tjaworski997/whisli-bean/docs/screens/pl/button-edit.png

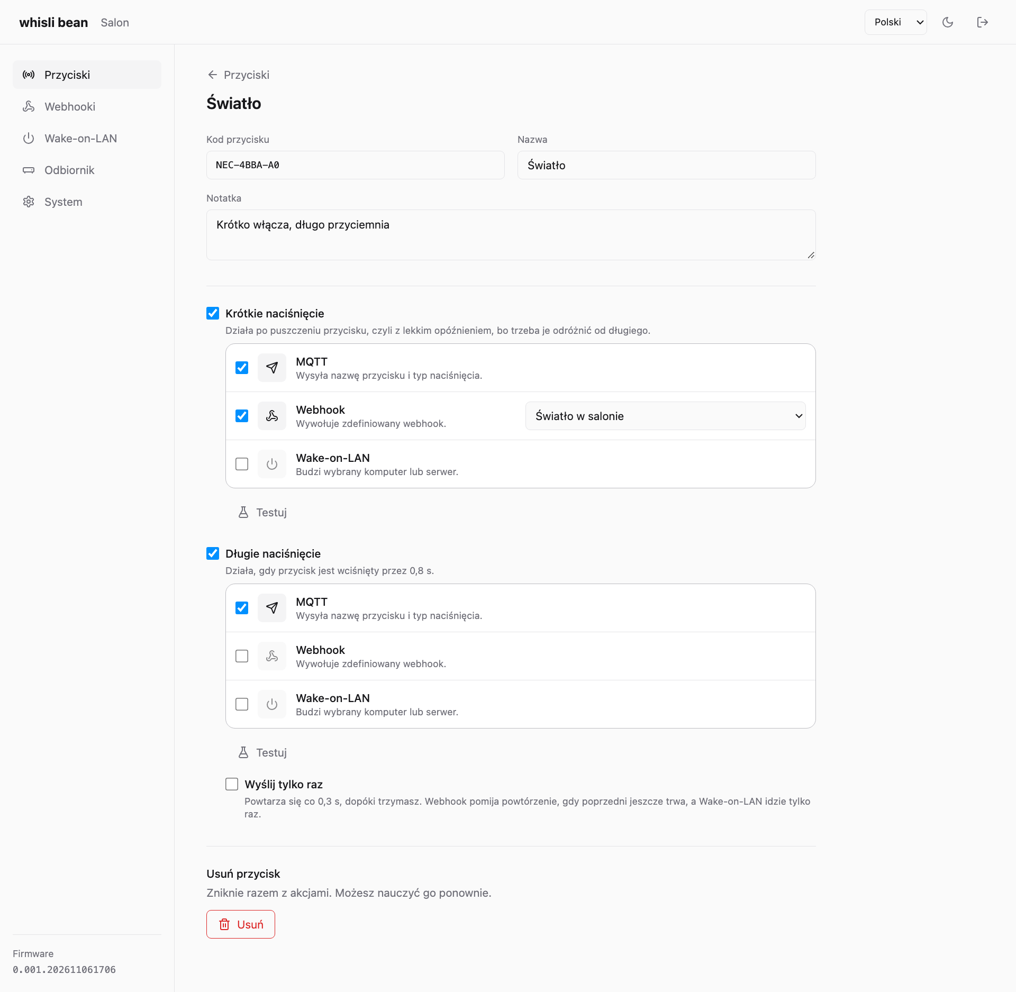
docs/screens/pl/button-edit.png
