tjaworski997/whisli-bean/docs/screens/pl/buttons.png

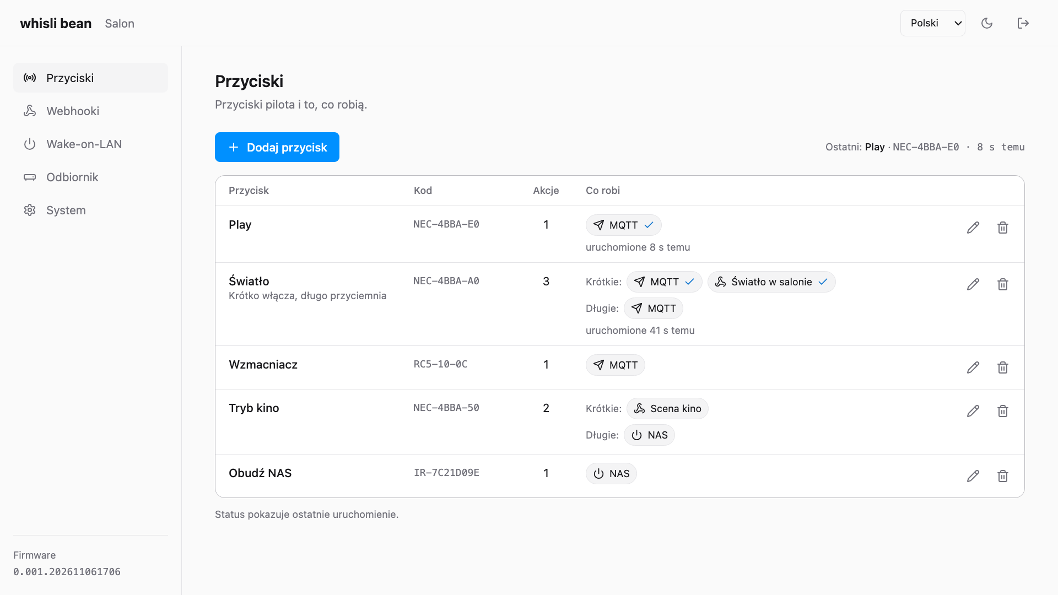
docs/screens/pl/buttons.png
