tjaworski997/whisli-bean/docs/screens/pl/logs.png

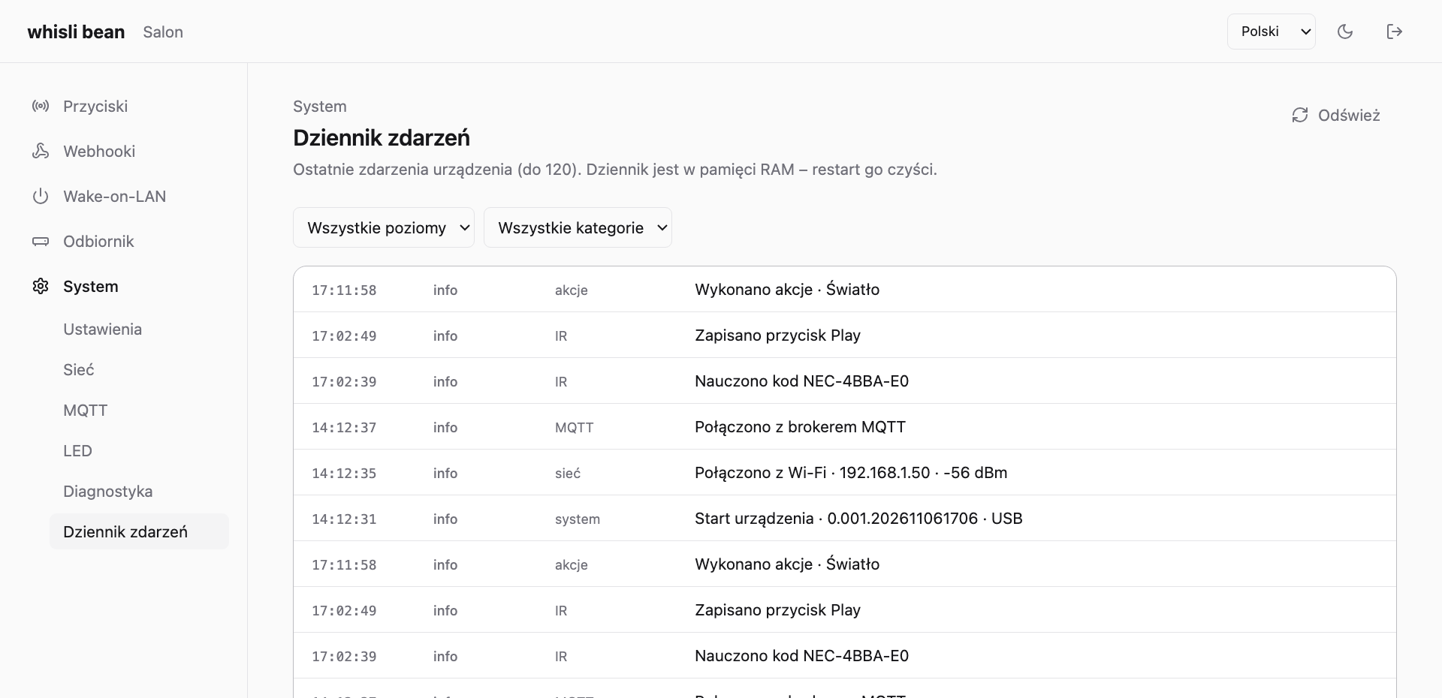
docs/screens/pl/logs.png
