tjaworski997/whisli-bean/docs/screens/pl/mqtt.png

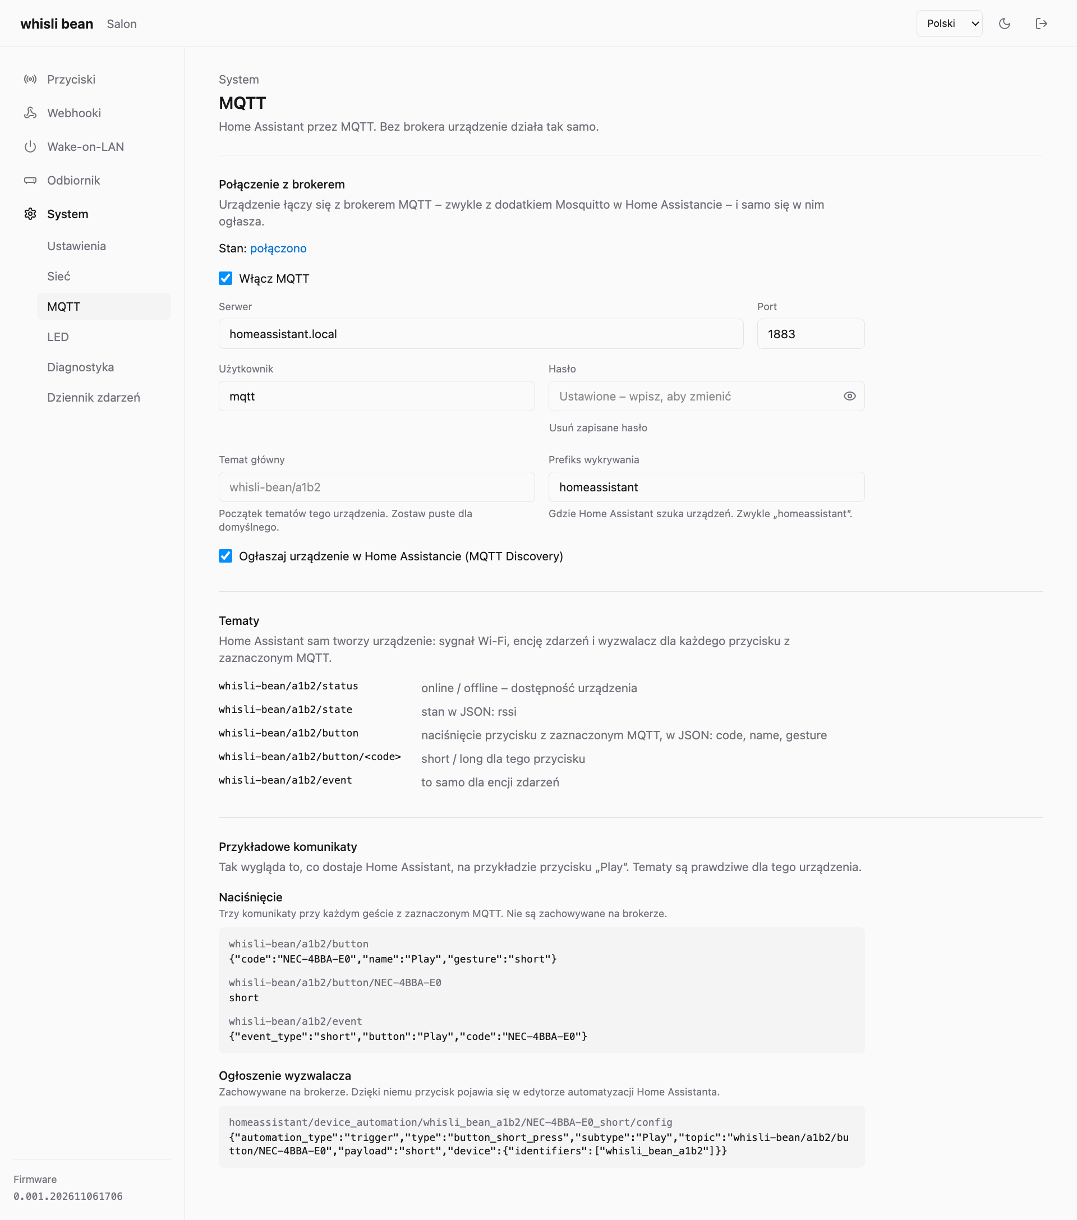
docs/screens/pl/mqtt.png
