tjaworski997/whisli-bean/docs/screens/pl/phone.png

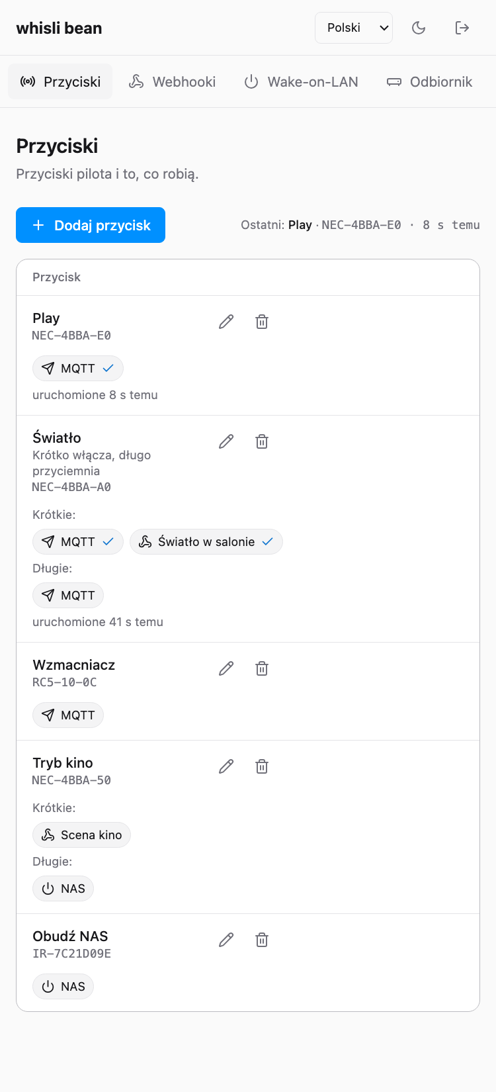
docs/screens/pl/phone.png
