tjaworski997/whisli-bean/docs/screens/pl/receiver.png

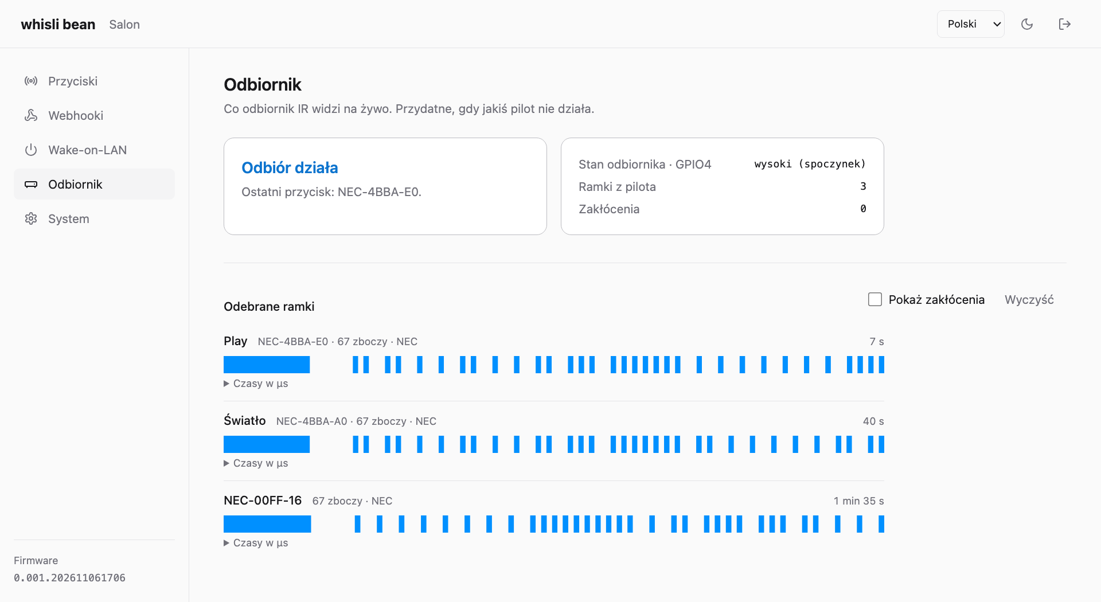
docs/screens/pl/receiver.png
