tjaworski997/whisli-bean/docs/screens/pl/settings.png

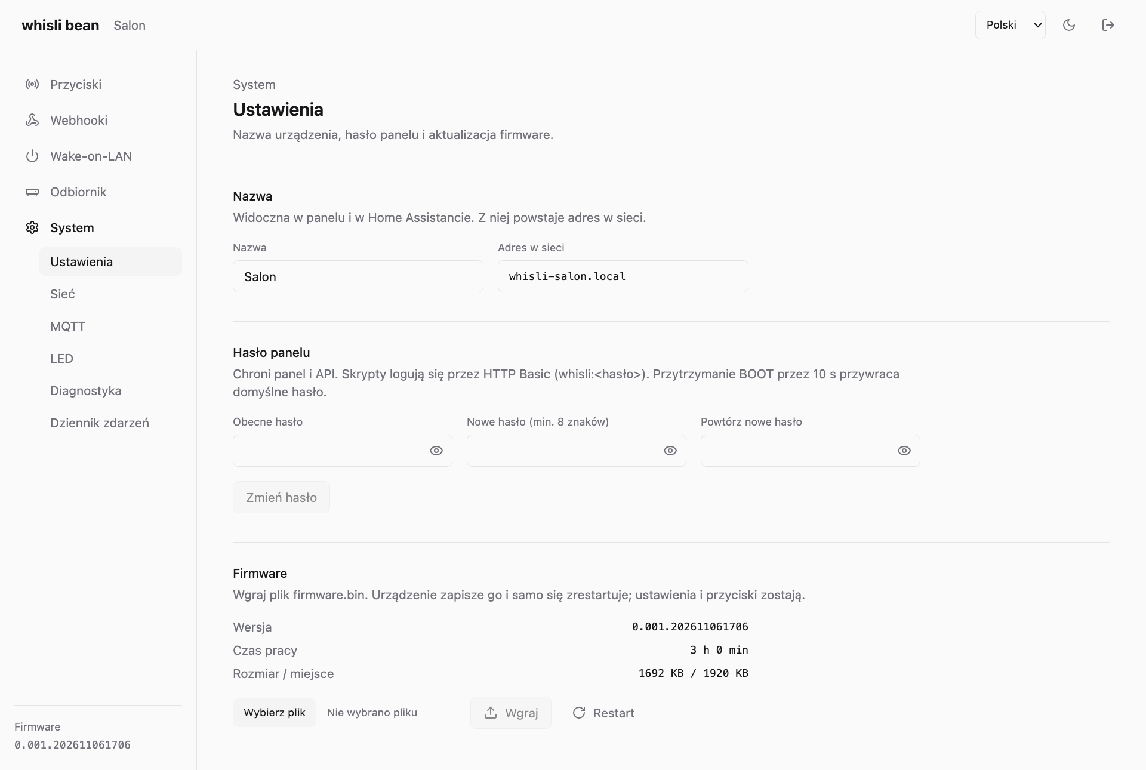
docs/screens/pl/settings.png
