tjaworski997/whisli-bean/docs/screens/pl/wake-on-lan.png

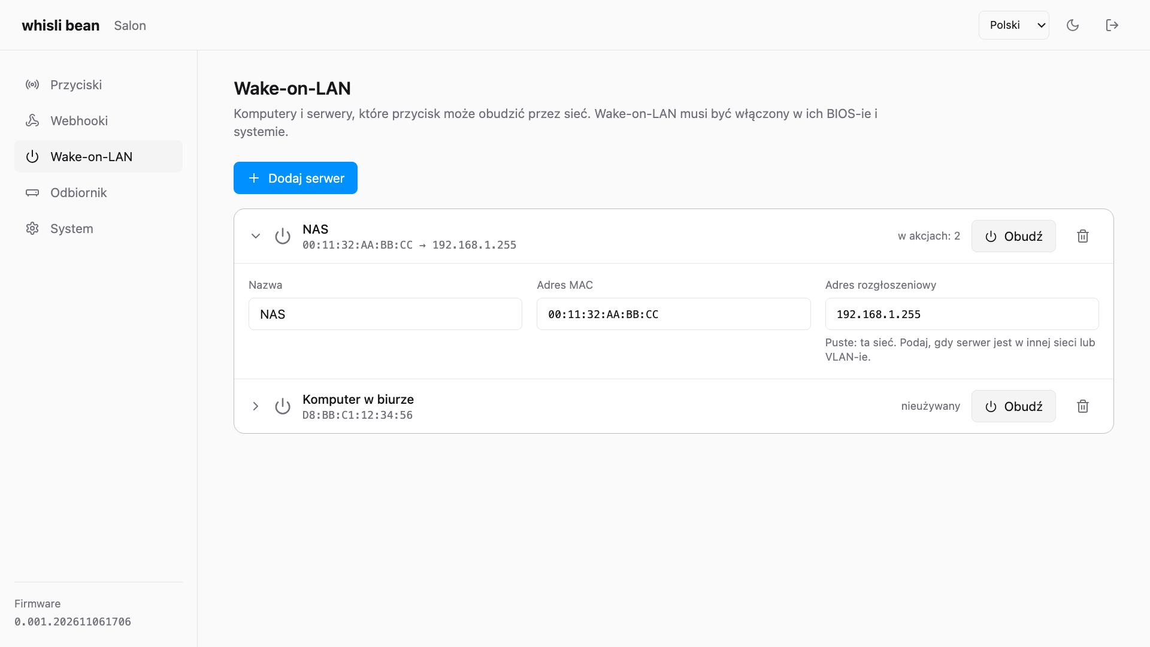
docs/screens/pl/wake-on-lan.png
