tjaworski997/whisli-bean/hardware/enclosure/preview/dno.png

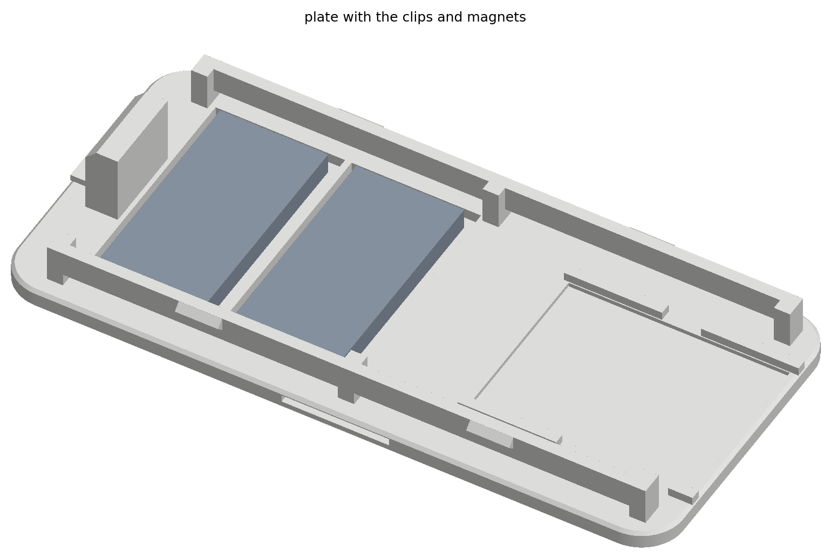
hardware/enclosure/preview/dno.png
