tjaworski997/whisli-bean/hardware/enclosure/preview/gora.png

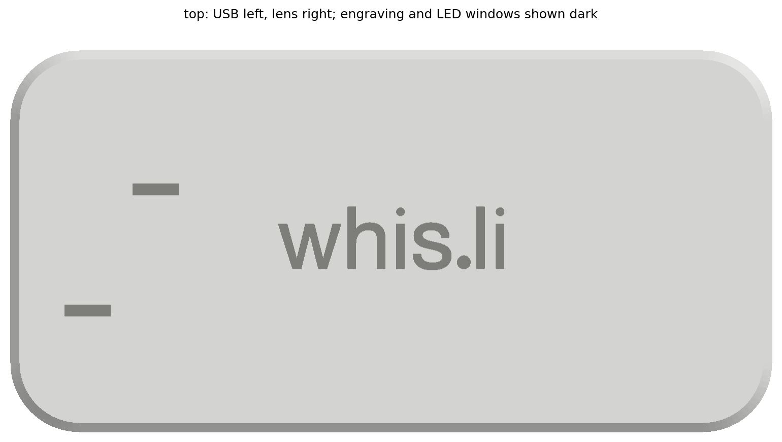
hardware/enclosure/preview/gora.png
