tjaworski997/whisli-bean/hardware/enclosure/preview/korpus-od-srodka.png

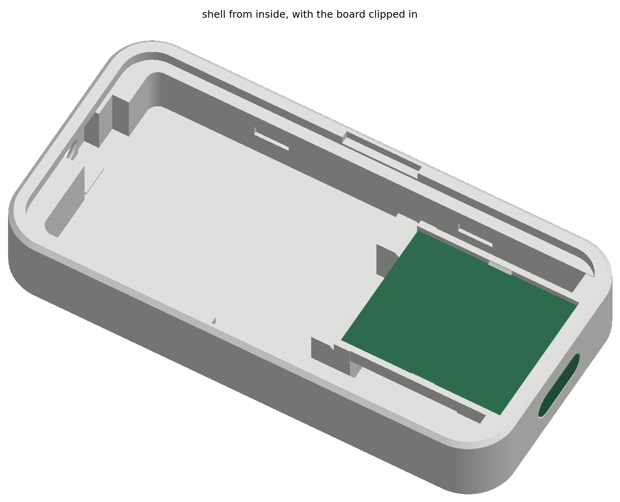
hardware/enclosure/preview/korpus-od-srodka.png
