tjaworski997/whisli-bean/hardware/enclosure/preview/napis.png

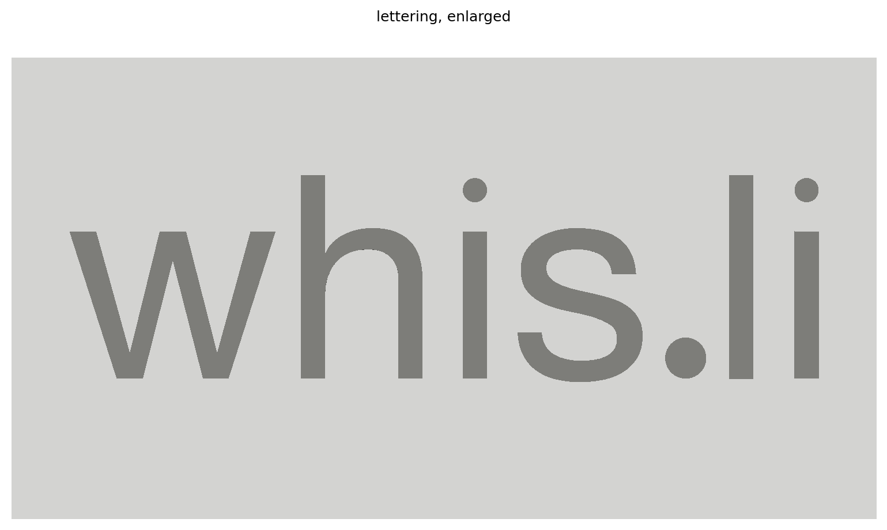
hardware/enclosure/preview/napis.png
