tjaworski997/whisli-bean/hardware/enclosure/preview/przekroj.png

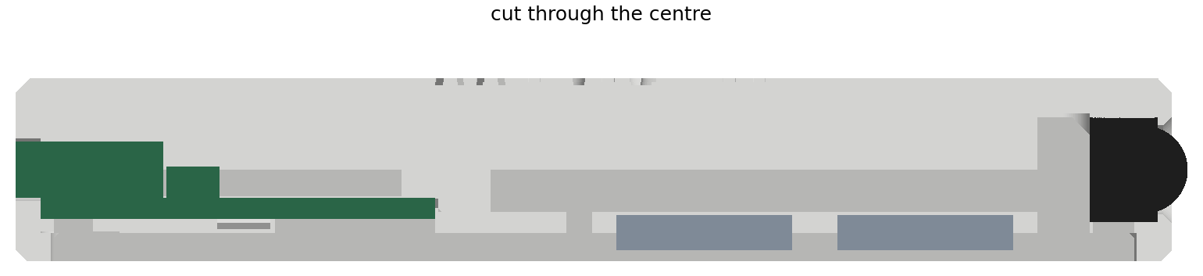
hardware/enclosure/preview/przekroj.png
