tjaworski997/whisli-bean/hardware/enclosure/preview/rozstrzelony.png

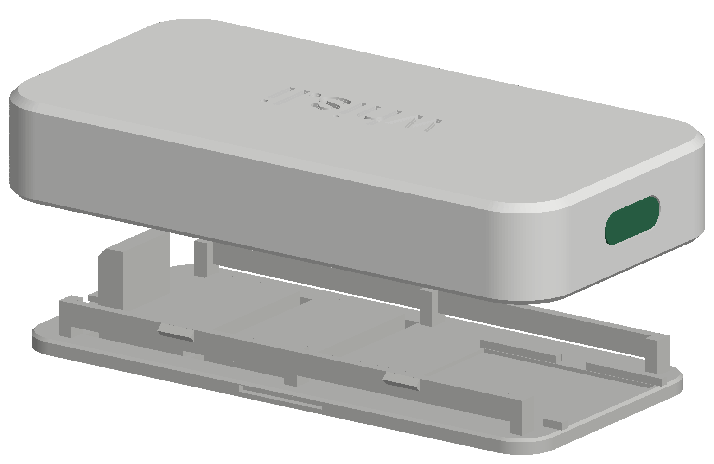
hardware/enclosure/preview/rozstrzelony.png
