tjaworski997/whisli-bean/hardware/enclosure/preview/spod.png

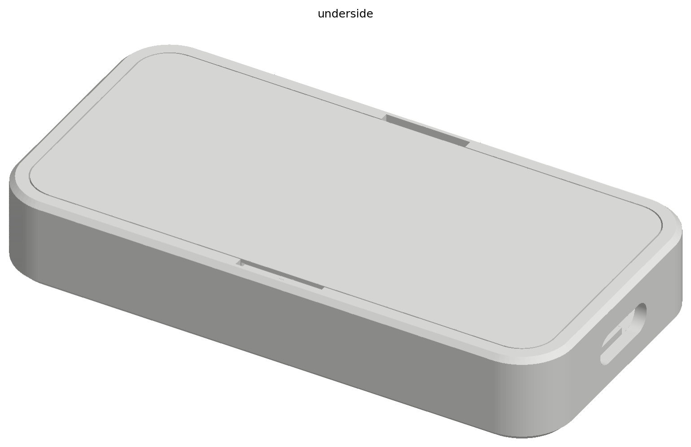
hardware/enclosure/preview/spod.png
