tjaworski997/whisli-bean/hardware/enclosure/preview/zlozony-usb.png

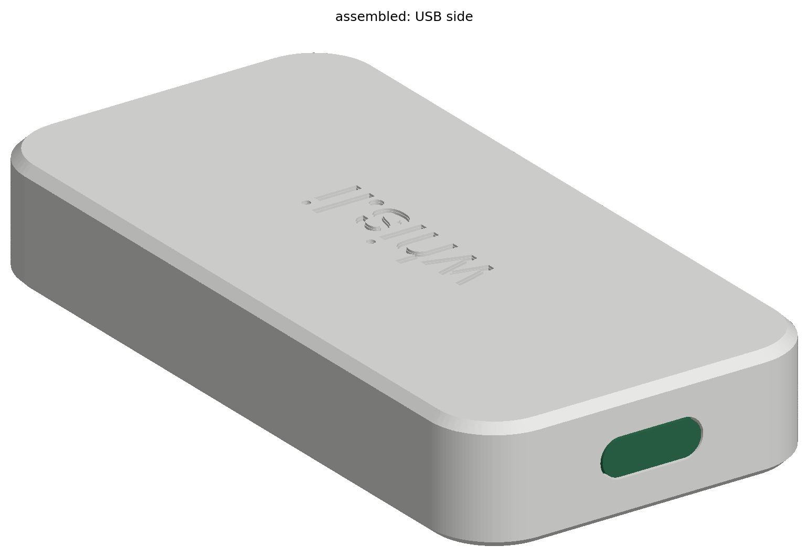
hardware/enclosure/preview/zlozony-usb.png
