tjaworski997/whisli-bean/hardware/enclosure/print/korpus.stl

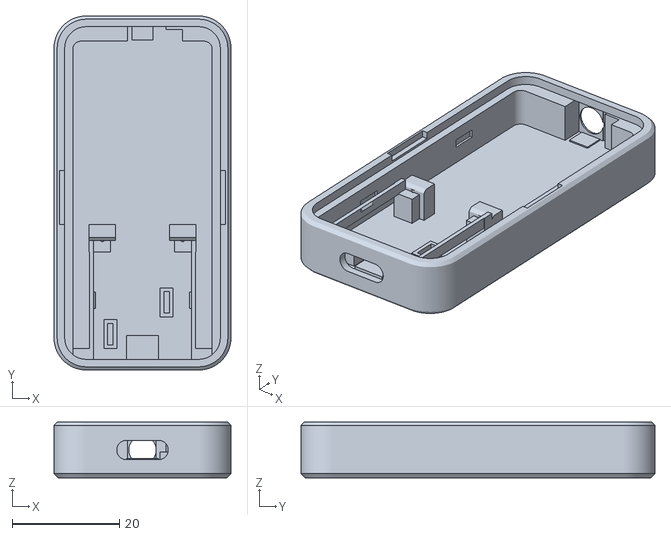
[picture p34: CAD file, 2026-11-06]
hardware/enclosure/print/korpus.stl
33.0 x 66.0 x 10.4
