tjaworski997/whisli-bean/hardware/enclosure/print/whisli-bean-obudowa.step

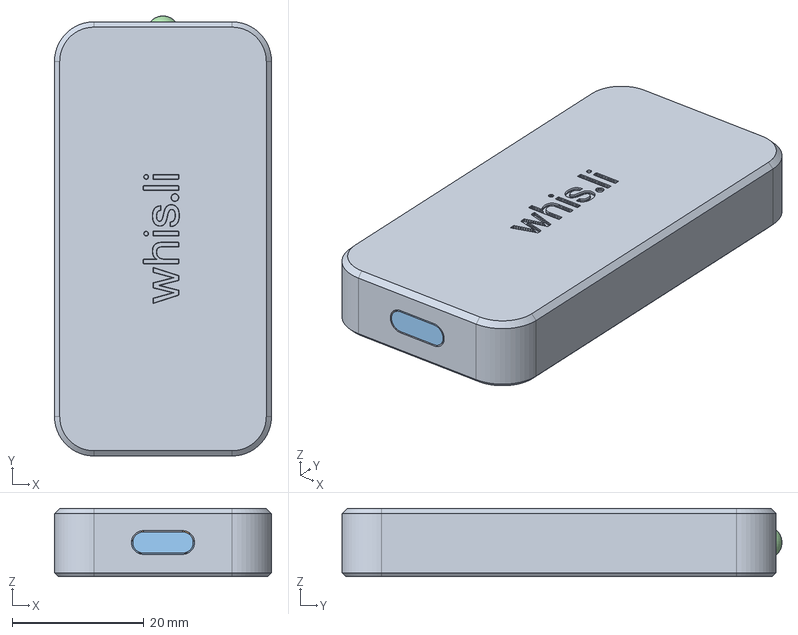
[picture p35: CAD file, 2026-11-06]
hardware/enclosure/print/whisli-bean-obudowa.step
33.0 x 66.9 x 10.4 mm
