tjaworski997/whisli-bean/hardware/enclosure/print/dno.stl

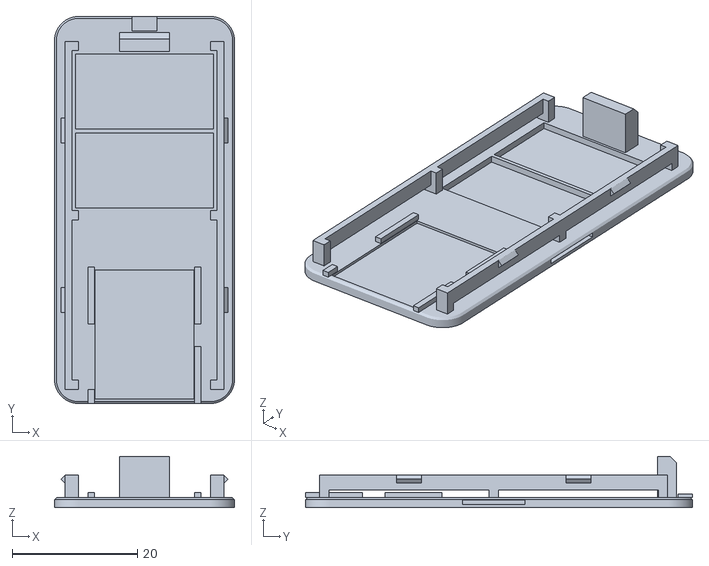
[picture p36: CAD file, 2026-11-06]
hardware/enclosure/print/dno.stl
28.7 x 61.7 x 8.20
